triffid/ESC/Schematic and Board/ESC.brd

## EAGLE design Schematic and Board/ESC.brd (2014-12-03)

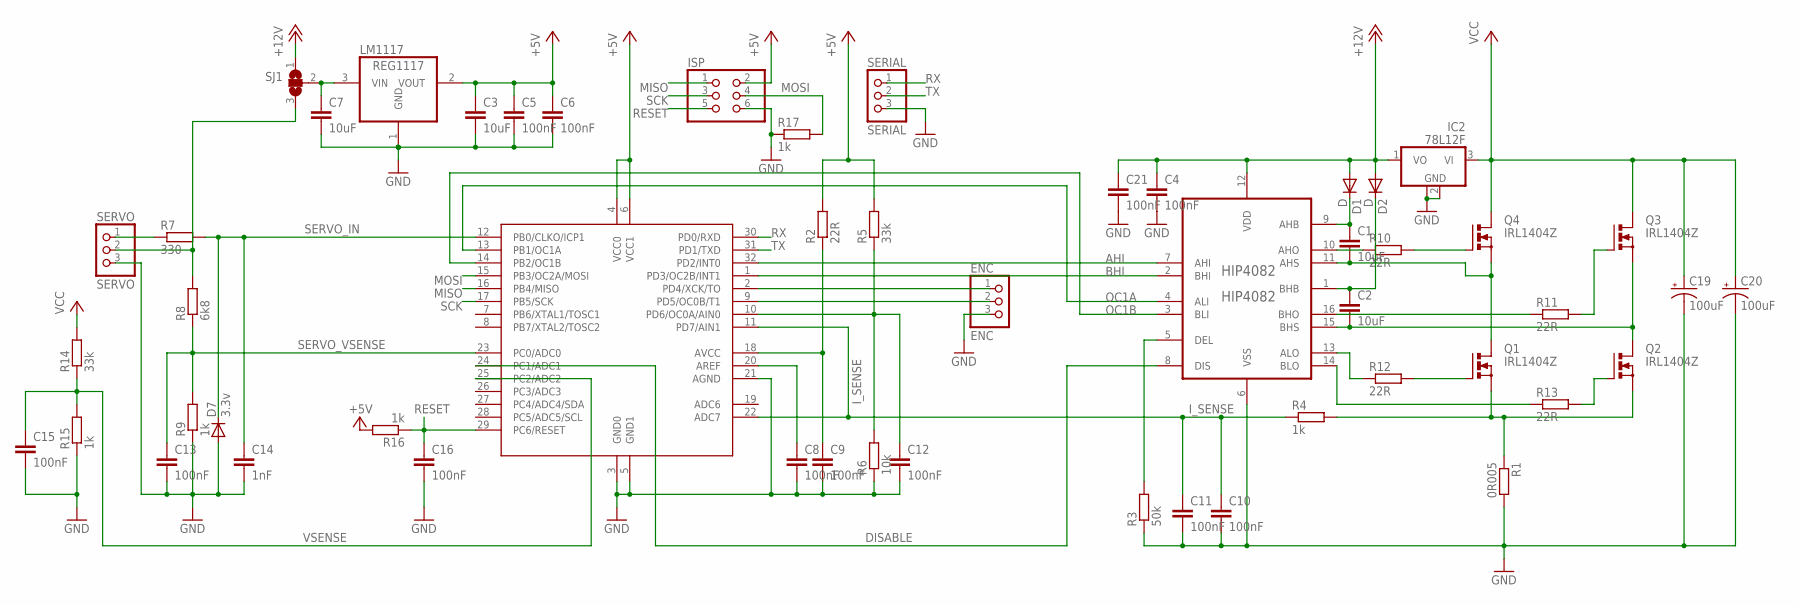
[picture p1: schematic ESC.sch]

Parts:
ATMEGA328: ATMEGA328; MLF32
C1, C2, C3, C7: 10uF; C0805K
C4, C5, C6, C8, C9, C10, C11, C12, C13, C15, C16, C21: 100nF; C0603K
C14: 1nF; C0603K
C19, C20: 100uF; PANASONIC_D
D1, D2: D; SOD110-R
D7: 3.3v; SOD-123_MINI-SMA
ENC: ENC; 1X03
HIP4082: HIP4082; SOIC127P600X175-16N
IC2: 78L12F; SOT89
ISP: PINHD-2X3; 2X03
LM1117: REG1117; SOT223
Q1, Q2, Q3, Q4: IRL1404Z; TO220BV
R1: 0R005; R2512
R2, R10, R11, R12, R13: 22R; R0603
R3: 50k; R0603
R4, R9, R15, R16, R17: 1k; R0603
R5, R14: 33k; R0603
R6: 10k; R0603
R7: 330; R0805
R8: 6k8; R0603
SERIAL: SERIAL; 1X03
SERVO: SERVO; 1X03
SJ1: SJ2W; SJ_2

Connections:
+5V: ATMEGA328.4 (VCC0), ATMEGA328.6 (VCC1), C3.1, C5.1, C6.1, ISP.2, LM1117.2 (VOUT), R2.2, R5.2, R16.2
+12V: C4.1, C21.1, D1.A, D2.A, HIP4082.12 (VDD), IC2.1 (VO), SJ1.1
AHI: ATMEGA328.32 (PD2/INT0), HIP4082.7 (AHI)
BHI: ATMEGA328.1 (PD3/OC2B/INT1), HIP4082.2 (BHI)
DISABLE: ATMEGA328.24 (PC1/ADC1), HIP4082.8 (DIS)
GND: ATMEGA328.3 (GND0), ATMEGA328.5 (GND1), ATMEGA328.21 (AGND), C3.2, C4.2, C5.2, C6.2, C7.2, C8.2, C9.2, C10.2, C11.2, C12.2, C13.2, C14.2, C15.2, C16.2, C19.-, C20.-, C21.2, D7.A, ENC.3, HIP4082.6 (VSS), IC2.2 (GND), IC2.2@1 (GND), ISP.6, LM1117.1 (GND), R1.2, R3.1, R6.1, R9.1, R15.1, R17.1, SERIAL.3, SERVO.3
I_SENSE: ATMEGA328.11 (PD7/AIN1), ATMEGA328.22 (ADC7), C10.1, C11.1, R4.1
MISO: ATMEGA328.16 (PB4/MISO), ISP.1
MOSI: ATMEGA328.15 (PB3/OC2A/MOSI), ISP.4, R17.2
MO_A: C1.2, HIP4082.11 (AHS), Q1.D, Q4.S
MO_B: C2.2, HIP4082.15 (BHS), Q2.D, Q3.S
unnamed: HIP4082.14 (BLO), R13.1
unnamed: HIP4082.13 (ALO), R12.1
unnamed: HIP4082.5 (DEL), R3.2
unnamed: Q4.G, R10.2
unnamed: HIP4082.10 (AHO), R10.1
unnamed: C1.1, D1.C, HIP4082.9 (AHB)
unnamed: C2.1, D2.C, HIP4082.1 (BHB)
unnamed: ATMEGA328.18 (AVCC), C9.1, R2.1
unnamed: HIP4082.16 (BHO), R11.1
unnamed: ATMEGA328.20 (AREF), C8.1
unnamed: ATMEGA328.10 (PD6/OC0A/AIN0), C12.1, R5.1, R6.2
unnamed: Q3.G, R11.2
unnamed: R7.1, SERVO.1
unnamed: R8.2, SERVO.2, SJ1.3
unnamed: Q1.G, R12.2
unnamed: ATMEGA328.2 (PD4/XCK/TO), ENC.1
unnamed: Q2.G, R13.2
unnamed: C7.1, LM1117.3 (VIN), SJ1.2
unnamed: ATMEGA328.9 (PD5/OC0B/T1), ENC.2
OC1A: ATMEGA328.13 (PB1/OC1A), HIP4082.4 (ALI)
OC1B: ATMEGA328.14 (PB2/OC1B), HIP4082.3 (BLI)
RESET: ATMEGA328.29 (PC6/RESET), C16.1, ISP.5, R16.1
RX: ATMEGA328.30 (PD0/RXD), SERIAL.1
SCK: ATMEGA328.17 (PB5/SCK), ISP.3
SENSE: Q1.S, Q2.S, R1.1, R4.2
SERVO_IN: ATMEGA328.12 (PB0/CLKO/ICP1), C14.1, D7.C, R7.2
SERVO_VSENSE: ATMEGA328.23 (PC0/ADC0), C13.1, R8.1, R9.2
TX: ATMEGA328.31 (PD1/TXD), SERIAL.2
VCC: C19.+, C20.+, IC2.3 (VI), Q3.D, Q4.D, R14.2
VSENSE: ATMEGA328.25 (PC2/ADC2), C15.1, R14.1, R15.2

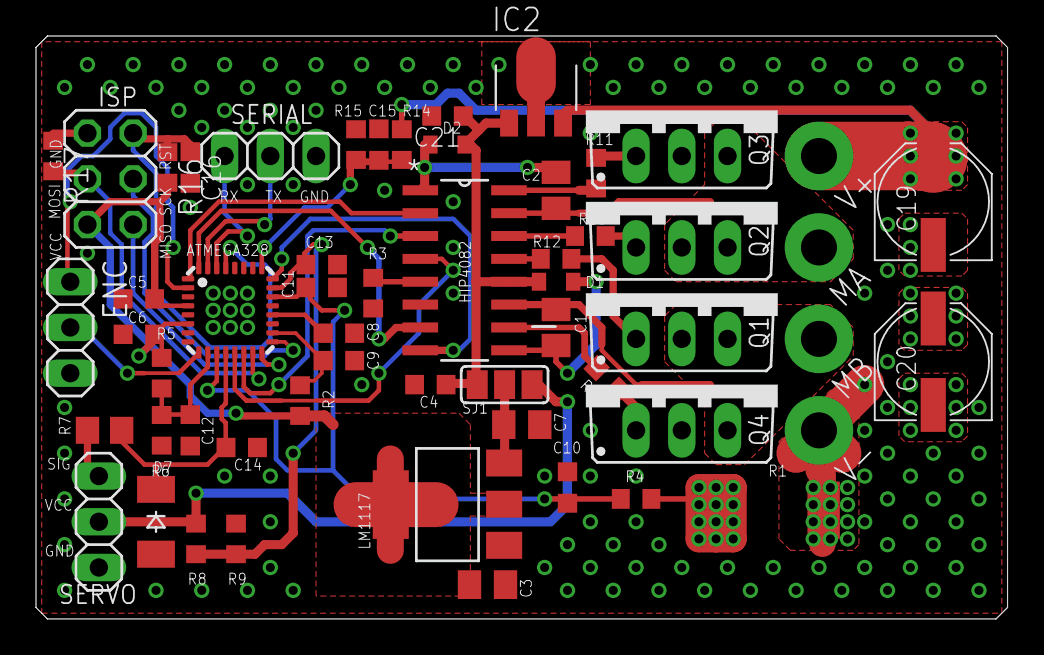
[picture p2: board ESC.brd from above]

Board: 2 copper layers, 54.0 x 32.4 mm, 52 parts (0 on the bottom side), 41 nets.
