triffid/ESC/pins.h

#ifndef _PINS_H
#define _PINS_H

#define SERVO_IN	PB0

#define SERIAL_TX	PD1
#define SERIAL_RX	PD0

// #define MOSI			PB3
// #define MISO			PB4
// #define SCK				PB5

#define ENC_P0		PD4
#define ENC_P1		PD5

#define AHI			PD2
#define ALO			PB1
#define BHI			PD3
#define BLO			PB2

#define DISABLE		PC1

// analog pins!
#define SERVO_VSENSE	0
#define	MOTOR_VSENSE	2
#define ISENSE			7

#define AIN0			PD6
#define	AIN1			PD7

#endif /* _PINS_H */
