triffid/ESC/(commit log)

2012-11-18 initial commit: PCB design
    [ESC.brd, ESC.sch]
2012-11-18 updated board: makes better use of PWM outputs, also adds optional ACS712 hall effect current sensor
    [ESC.brd, ESC.sch]
2012-11-18 ESC Firmware: working on altered versions of initial board design, should in theory work on current board design
2012-11-18 add lots of comments, license, headers in a few files. also remove redundant stuff from esc.c
2014-12-03 24V adaption - add 7812, expand board, add VMM capacitors, add encoder input.
    [ESC.brd, ESC.sch]
2014-12-03 solve potential race condition on servo_pulse_width, update gitignore
2014-12-03 Minor tidying
    [ESC.brd, ESC.sch]
2014-12-03 More board tweaks
    [ESC.brd, ESC.sch]
2014-12-03 Remove ACS712, improve ground stitching and layout
    [ESC.brd, ESC.sch]
